AidanMcNulty/Projet-PPS1/Boitier_3d_XAAN v1.step

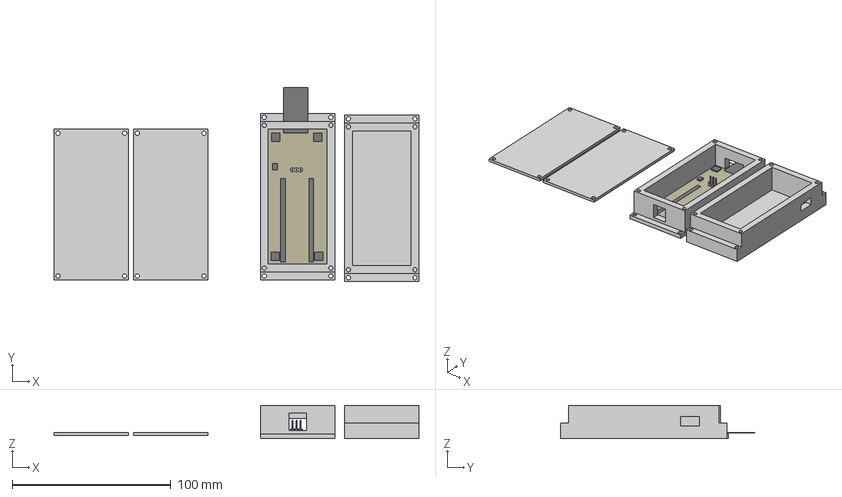
[picture p4: CAD file, 2024-11-07]
Boitier_3d_XAAN v1.step
230.0 x 122.3 x 21.0 mm
Board
SAMTEC_ESQ-120-13-G-S x 2
M1206 x 2
DHT22
10X02MTA
2,8-PAD x 4
1X03
