AidanMcNulty/Projet-PPS1/(list of files, cad)

Other CAD files:
Boitier_3d_XAAN v1.f3z
Boitier_3d_XAAN v1.stl
