AidanMcNulty/Projet-PPS1/PPS1_matriciel_V4.brd

## EAGLE design PPS1_matriciel_V4.brd (2024-11-07)

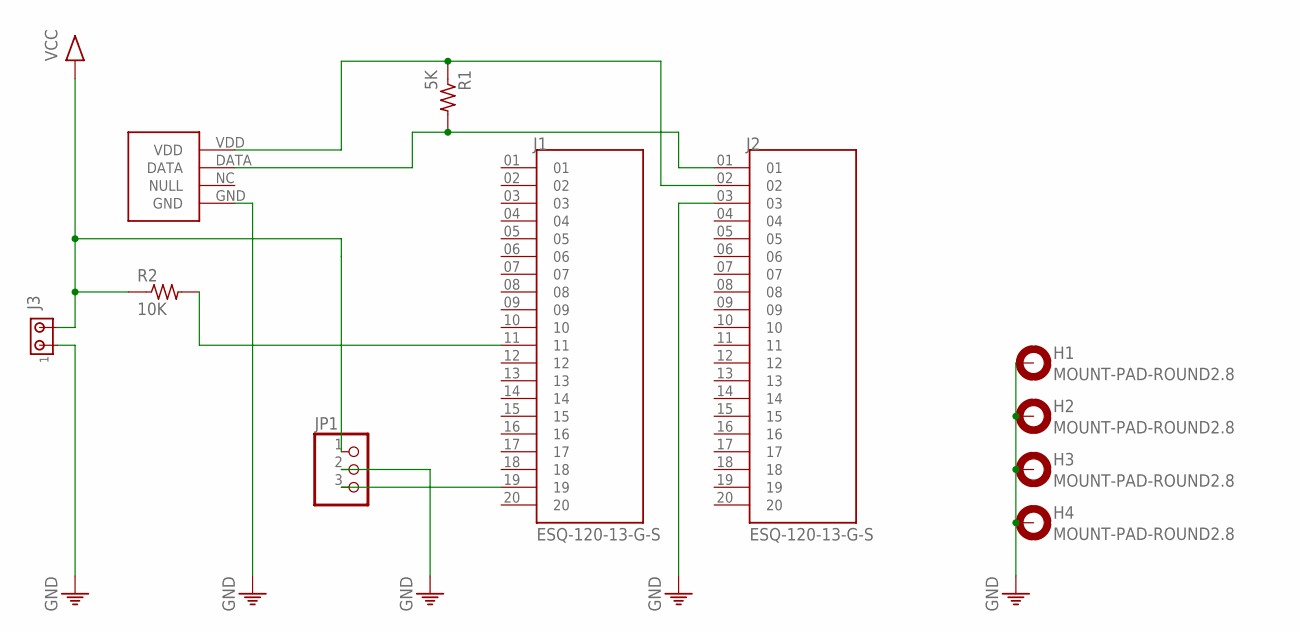
[picture p5: schematic PPS1_schemas_V2.sch]

Parts:
H1, H2, H3, H4: MOUNT-PAD-ROUND2.8; 2,8-PAD
J1, J2: ESQ-120-13-G-S; SAMTEC_ESQ-120-13-G-S
J3: MTA02-100; 10X02MTA
JP1: PINHD-1X3; 1X03
R1: 5K; M1206
R2: 10K; M1206
U$1: DHT22

Connections:
GND: H1.B2,8, H2.B2,8, H3.B2,8, H4.B2,8, J1.18, J2.03, J3.1, JP1.2, U$1.GND
unnamed: J2.01, R1.2, U$1.DATA
unnamed: J2.02, R1.1, U$1.VDD
unnamed: J1.11, R2.2
unnamed: J1.19, JP1.3
VCC: J3.2, JP1.1, R2.1

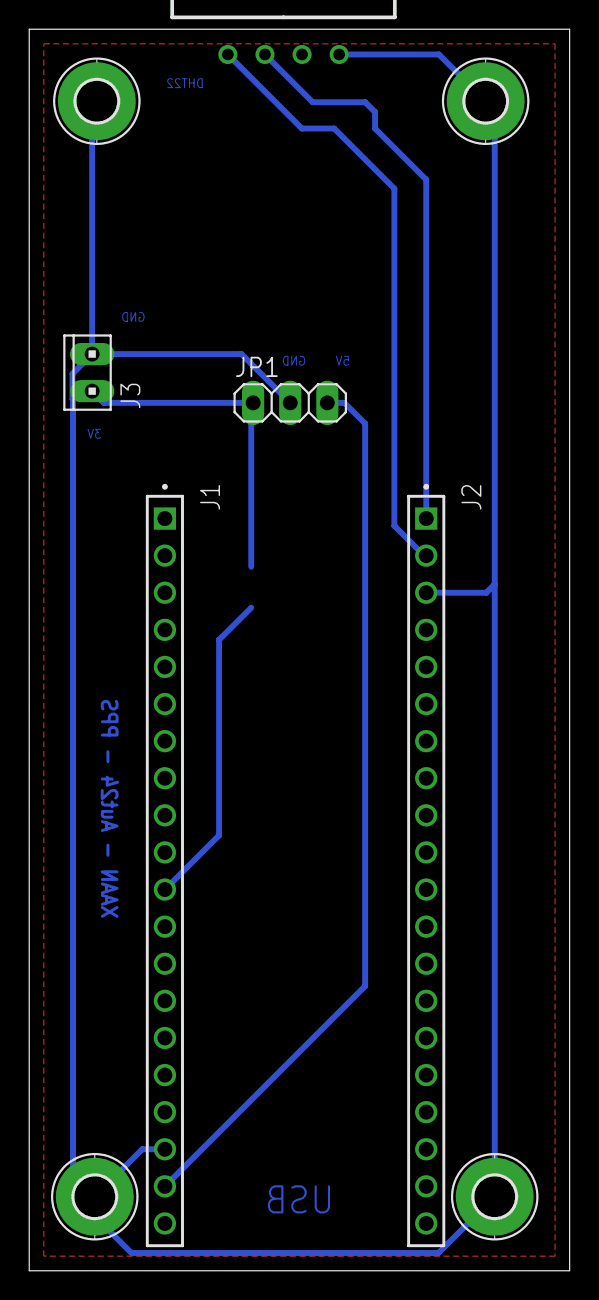
[picture p6: board PPS1_matriciel_V4.brd from above]

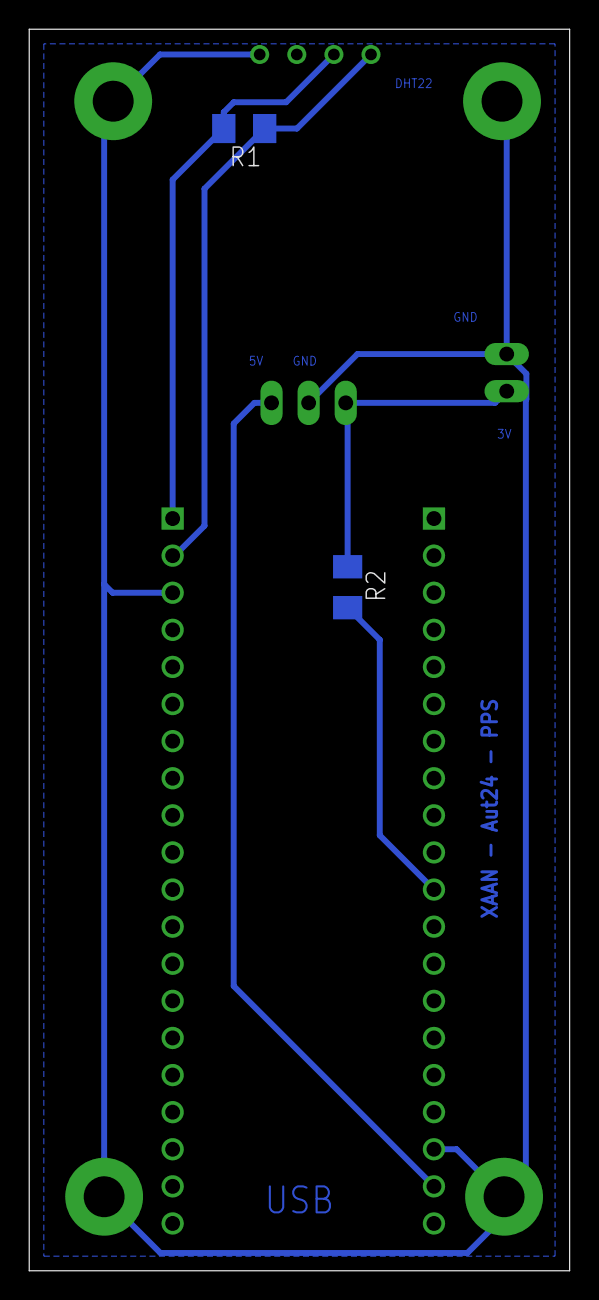
[picture p7: board PPS1_matriciel_V4.brd from below]

Board: 2 copper layers, 37.0 x 85.0 mm, 11 parts (2 on the bottom side), 6 nets.
