AidanMcNulty/Projet-PPS1/Liste_des_problemesJ_solutions_et_choix.xlsx

Dans cette colomne préciser le nom de votre équipe | Dans cette colomne préciser le titre de votre projet PPSx | Dans cette colomne compléter les Prénoms, Noms de l'équipe |  |  | Dans cette colomne décrire au moins 3 problèmes rencontrés pour chaque composante (matérielle, logicielle, réseau et cloud) | Dans cette colomne décrire les solutions envisagées en vis à vis de chaque problème | Dans cette colomne préciser quelle solution a été choisie | Dans cette colomne préciser pour quelles raisons la solution a été choisie
Projet | Équipe | Membres de l'équipe | Composante | Problème | Description du problème | Solutions | Choix | Argumentation
Projet PPS1 | XAAN | Aidan McNulty, Alexandre Nadeau, Nathan-Raphaël Tassé et Xavier Robitaille | Matérielle (au sens électronique : PCB, plaque à essai, ...) | 1 | Notre premier modèle de PCB ne respectait pas vraiment les critères imposés par le cahier des charges, car il était trop gros | 1 :Réduire la taille de notre PCB. | Choix 1 | Problème 1 : Nous n’avions pas vraiment le choix et avons dû opter pour cette solution, car il fallait réduire la taille de notre PCB pour que le boîtier ne soit pas trop volumineux et puisse être accroché au plafond. Problème 2 : Nous avons décidé d’opter pour l’utilisation d’un module Boost, car il était essentiel d’avoir une alimentation stabilisée, et notre client voulait conserver la même capacité pour les batteries. Cette option était donc la meilleure pour notre cas. Problème 3 : Étant donné que nous étions limités par le temps, il n’était pas possible de refaire un PCB, et connecter les fils directement sur les traces aurait été compliqué en raison de leur épaisseur. Nous avons donc choisi de souder les fils d’alimentation directement sur les pins VIN et GND du header pour le module Boost.
 |  |  |  |  |  | 2:
 |  |  |  |  |  | 3 :
 |  |  |  | 2 | Au début, notre système était seulement alimenté directement par les batteries, mais lorsque l'alimentation descendait sous les 2,5 V environ, le module WiFi ne fonctionnait plus sur notre R-Pi Pico. | 1: Utiliser un module Boost entre nos piles et notre R-Pi Pico afin d'assurer une alimentation stable de 5 V. | Choix 1
 |  |  |  |  |  | 2 :Augmenter la capacité des batteries.
 |  |  |  | 4 | Lors de la soudure de notre PCB, le pad de cuivre pour l'alimentation s'est décollé du PCB, donc notre pin d'alimentation n'était plus connectée avec notre trace d'alimentation. | 1 :Connecter nos fils d'alimentations directement sur la trace d'alimentation et sur le plan de masse . | Choix 2
 |  |  |  |  |  | 2 :Connecter nos fils d'alimentations direcrement sur les pins headers du module Boost (Vin et GND).
 |  |  |  |  |  | 3 :Refaire un PCB, mais cette fois avec des pads de cuivre plus larges pour éviter que le problème se reproduise.
 |  |  | Logicielle (embarqué) | 1 | Nous n'avons pas de partie dans notre code pour indiquer si le dispositif est allumé ou éteint, donc l'utilisateur n'a aucun moyen de connaître l'état du Raspberry Pi. | 1 : Amélioration: Implémenter une fonction pour afficher l'état du Raspberry Pi (activé ou désactivé). | Choix 1 | Problème 1 : Nous avons opté pour cette solution, car avec une LED, il faut être dans la même pièce pour voir si le Raspberry Pi est allumé ou non. En intégrant une fonction dans le code, on peut voir directement l'état sur le serveur web, ce qui est plus efficace. Problème 2 : Nous avons choisi cette solution, car elle est simple à intégrer dans le code et très efficace. En mode veille, le Raspberry Pi consomme seulement quelques microampères, donc elle peut survivre beaucoup pus longtemps sur une paire de pile. Problème 3 : Nous avons choisi cette option pour une raison évidente : une pile se décharge de manière exponentielle décroissante, donc avec une formule linéaire, nous ne lisions pas correctement le niveau des piles.
 |  |  |  |  |  | 2 : Ajouter une LED qui s’allume ou s’éteint avec le Raspberry Pi.
 |  |  |  |  |  | 3 :
 |  |  |  | 2 | Notre code n'est pas optimisé pour que les piles puissent durées plusieurs mois voir année. | 1 : Amélioration: Mettre le Raspberry Pi en mode veille lorsqu'il n'envoie pas de données. | Choix 1
 |  |  |  |  |  | 2 :
 |  |  |  | 3 | Notre calcul du pourcentage pour les piles était linéaire au lieu d'être exponentielle donc le pourcentage vue sur thingsboard n'était pas réellement la vraie tension des piles. | 1 :Amélioration: Faire une fonction exponentielle au lieu de linéaire | Choix 1
 |  |  |  |  |  | 2 :
 |  |  |  |  |  | 3 :
 |  |  | Réseau (WiFi / LoRaWAN) | 1 | Il existe des limitations concernant la connexion Wi-Fi, car le SSID et le mot de passe sont codés en dur. Ainsi, lorsque le réseau Wi-Fi change, il est nécessaire de modifier manuellement les informations de connexion et de recharger le code sur le Raspberry Pi Pico. | 1 :Amélioration: Utiliser un mode de configuration via un point d'accès. | Choix 1 | Problème 1 : Nous avons opté pour cette solution, car avec cette méthode, aucun mot de passe Wi-Fi n'est enregistré dans les fichiers. Il suffit d'accéder au site web du Raspberry Pi et de saisir le nouveau SSID et mot de passe. Problème 2 : Nous avons choisi la première solution, car en activant seulement le Wi-Fi quand il est nécessaire, nous allons pouvoir économiser beaucoup d'énergie. On peut faire ceci en se connectant seulement une petit periode de temps pour envoyer les donnés et une fois les donnés envoyés, on se déconnecte.
 |  |  |  |  |  | 2 : Stocker les informations Wi-Fi dans un fichier de configuration
 |  |  |  |  |  | 3 :
 |  |  |  | 2 | Notre module Wi-Fi ne réduit pas sa puissance de transmission, donc il émettait toujours à pleine puissance, ce qui consommait beaucoup d'énergie de nos piles. | 1 Amélioration :Activer le Wi-Fi uniquement quand nécessaire | Choix 1
 |  |  |  |  |  | 2 :Ajouter un module de gestion de puissance externe
 |  |  |  | 3 |  | 1 :
 |  |  |  |  |  | 2 :
 |  |  |  |  |  | 3 :
 |  |  | Cloud (ThingsBoard) | 1 | Le nom des clés d'identification envoyées depuis le code n'était pas le même que celui inscrit dans le cloud, donc les informations sur nos données ne s'affichaient pas dans le cloud. | 1 : S'assurer que les clés d'identification envoyées par le code ont les mêmes noms que celles demandées par le cloud. | Choix 1 | Problème 1 : Nous avons opté pour cette solution, car sans la bonne clé d'identification, il est impossible de recevoir les données du Raspberry Pi et de les afficher sur le tableau de bord.
 |  |  |  |  |  | 2 :
 |  |  |  |  |  | 3 :
 |  |  |  | 2 |  | 1 :
 |  |  |  |  |  | 2 :
 |  |  |  | 3 |  | 1 :
 |  |  |  |  |  | 2 :
 |  |  |  |  |  | 3 :
 |  |  | Boitier (3D) | 1 | Au début, nous n'avons pas utilisé la bonne méthode sur Fusion 360 pour concevoir notre boîtier 3D, et celui-ci ne respectait pas les dimensions correctes pour être imprimé. | 1 : Refaire la création du boîtier en prenant soin d'utiliser les croquis et de respecter les bonnes dimensions. | Choix 1 | Problème 1 : Nous étions obligés d'utiliser cette solution, car nous ne pouvions pas imprimer notre boîtier de cette façon, et il nous était impossible d'éditer notre design sans l'utilisation de croquis. Problème 2 : Étant donné que nous avions plus de temps pour imprimer un nouveau boîtier, nous avons dû découper une ouverture plus haute manuellement avec un X-Acto. Problème 3 : Comme nous disposions de plus de temps pour imprimer un nouveau boîtier, nous avons dû percer des trous entre les deux parties du boîtier manuellement avec une perceuse, afin de faire passer les fils entre les batteries et notre PCB.
 |  |  |  |  |  | 2 :
 |  |  |  |  |  | 3 :
 |  |  |  | 2 | L'ouverture créée sur notre boîtier pour permettre le branchement du Raspberry Pi Pico était trop basse. | 1 : Refaire le design du boîtier, en veillant cette fois à placer l'ouverture pour la connexion plus haut. | Choix 2
 |  |  |  |  |  | 2 : Utiliser un X-Acto pour découper manuellement une ouverture plus haute, permettant la connexion au Raspberry Pi Pico.
 |  |  |  | 3 | Nous n'avons pas pensé à la façon dont les batteries pourraient se connecter au PCB, car elles sont toutes deux dans des boîtiers différents. | 1 : Refaire le design du boîtier, cette fois en plaçant l'alimentation et le PCB dans la même partie, et non dans deux parties séparées. | Choix 4
 |  |  |  |  |  | 2 : Refaire le design du boîtier en incluant directement des trous entre les deux parties pour permettre le passage des fils de l'alimentation.
 |  |  |  |  |  | 3:Modifier notre facon d'alimenter notre PCB en ajoutant des supports à batteries souder directement sur notre PCB afin faire seulement une partie pour notre PCB aulieu de deux parties.
 |  |  |  |  |  | 4 : Utiliser une perceuse pour percer manuellement des trous entre les deux parties afin de faire passer les fils de l'alimentation.
