AidanMcNulty/Projet-PPS1/(commit log)

2024-10-24 Add files via upload
    Diagramme schématique
    [PPS1_schemas_V2.sch]
2024-10-24 Add files via upload
    Diagramme fonctionnelle
    [DiagrammeFonctionnelle_PPS1.sch]
2024-10-24 Add files via upload
    Diagramme matricielle
    [PPS1_schemas_V2.brd]
